2qiao22/STM32G473VET_main_controller_board/STM32G473VET_main_controller_board.kicad_pcb

## KiCad design STM32G473VET_main_controller_board.kicad_pcb (2026-08-07)

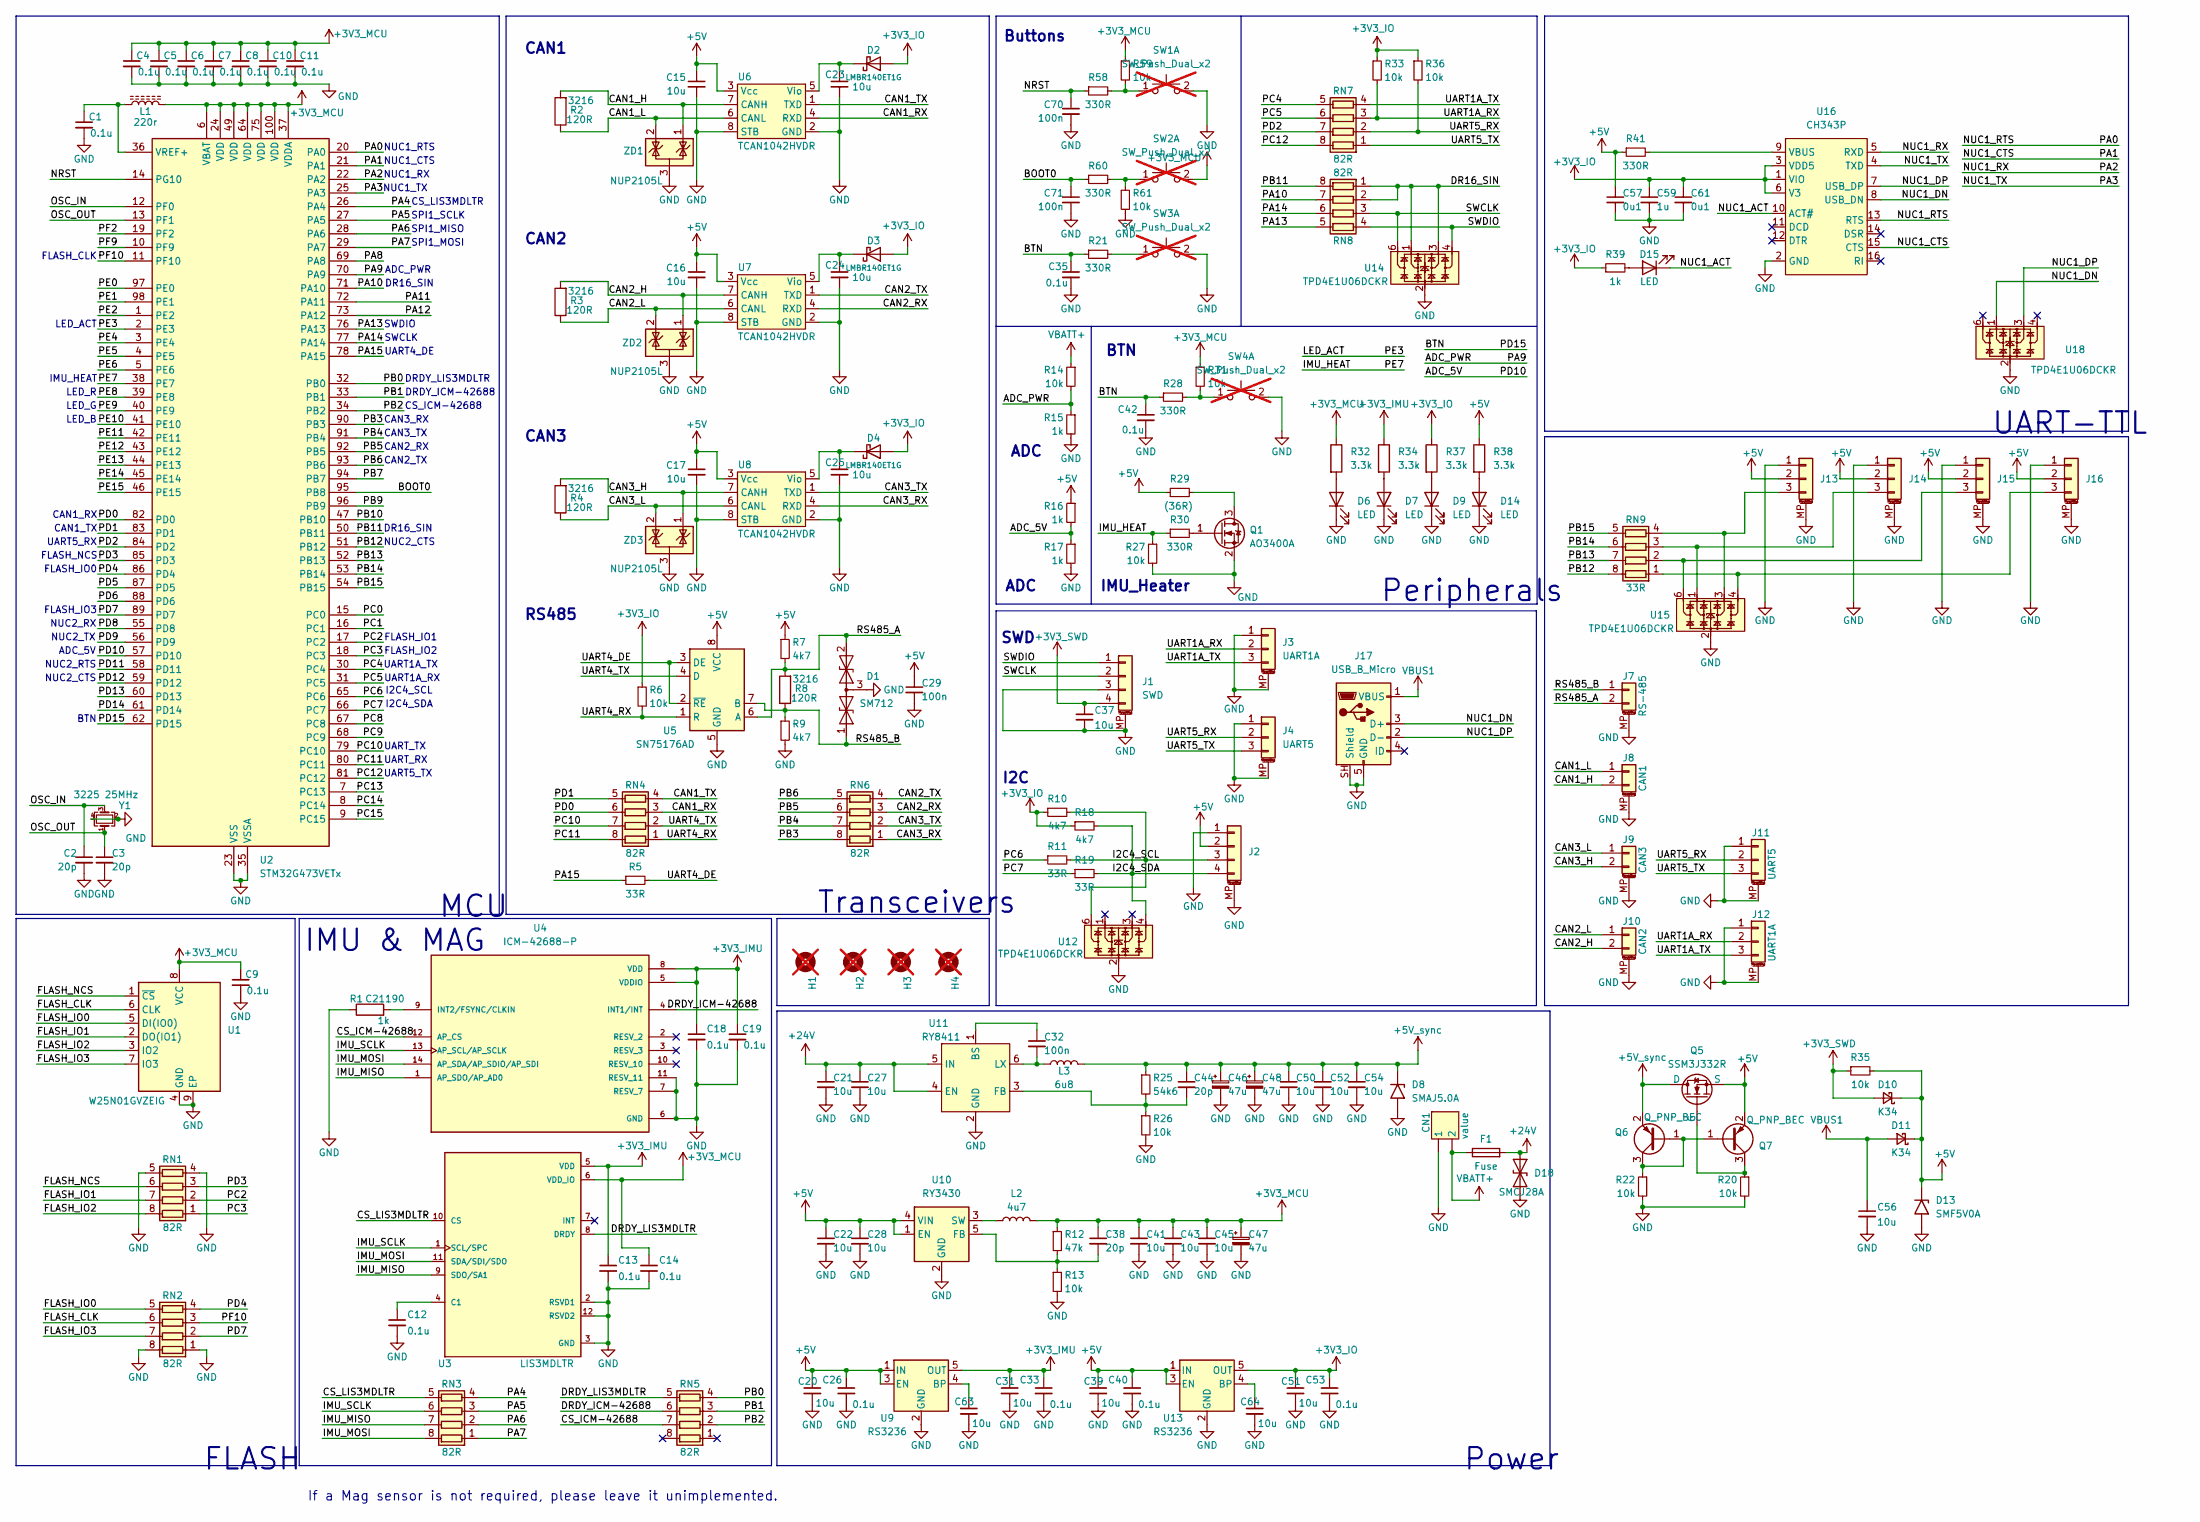
[picture p1: schematic STM32G473VET_main_controller_board.kicad_sch, STM32G473VET_General-purpose microcontroller board]

Parts:
C1, C4, C5, C6, C7, C8, C9, C10, C11, C12, C13, C14, C18, C19, C26, C33, C35, C40, C42, C53: 0.1u; C_0603_1608Metric; LCSC C14663
C2, C3, C38, C44: 20p; C_0603_1608Metric
C15, C16, C17, C20, C23, C24, C25, C31, C37, C39, C51, C56, C63, C64: 10u; C_1206_3216Metric; LCSC C13585
C21, C27, C50, C52, C54: 10u; C_1206_3216Metric
C22, C28, C41, C43, C45: 10u; C_0603_1608Metric
C29, C32, C70, C71: 100n; C_0603_1608Metric
C46, C47, C48: 47u; CP_EIA-3216-12_Kemet-S
C57, C61: 0u1; C_0603_1608Metric
C59: 1u; C_0603_1608Metric
CN1: value; AMASS_XT30PW-M_1x02_P2.50mm_Horizontal
D1: SM712; SOT-23
D2, D3, D4: LMBR140ET1G; D_TUMD2; LCSC C172430
D6, D7, D9, D14: LED; LED_0603_1608Metric; LCSC C510027
D8: SMAJ5.0A; D_SMA
D10, D11: K34; D_SMF
D13: SMF5V0A; D_SMF
D15: LED; LED_0603_1608Metric
D18: SMCJ28A; D_SMC
F1: Fuse; Fuse_1206_3216Metric
H1, H2, H3, H4: MountingHole; MountingHole_3.2mm_M3_ISO14580; not fitted
J1: SWD; Molex_PicoBlade_53398-0471_1x04-1MP_P1.25mm_Vertical
J2: Conn_01x04_MountingPin; 128x64OLED
J3: UART1A; JST_GH_BM03B-GHS-TBT_1x03-1MP_P1.25mm_Vertical
J4: UART5; JST_GH_BM03B-GHS-TBT_1x03-1MP_P1.25mm_Vertical
J7: RS-485; JST_GH_SM02B-GHS-TB_1x02-1MP_P1.25mm_Horizontal
J8: CAN1; JST_GH_SM02B-GHS-TB_1x02-1MP_P1.25mm_Horizontal
J9: CAN3; JST_GH_SM02B-GHS-TB_1x02-1MP_P1.25mm_Horizontal
J10: CAN2; JST_GH_SM02B-GHS-TB_1x02-1MP_P1.25mm_Horizontal
J11: UART5; JST_GH_SM03B-GHS-TB_1x03-1MP_P1.25mm_Horizontal
J12: UART1A; JST_GH_SM03B-GHS-TB_1x03-1MP_P1.25mm_Horizontal
J13, J14, J15, J16: Conn_01x03_MountingPin; JST_GH_BM03B-GHS-TBT_1x03-1MP_P1.25mm_Vertical
J17: USB_B_Micro; USB_Micro-B_Wuerth_629105150521
L1: 220r; L_0603_1608Metric
L2: 4u7; L_Sunlord_MWSA0402S
L3: 6u8; L_Sunlord_MWSA0402S
Q1: AO3400A; SOT-23
Q5: SSM3J332R; SOT-23-3
Q6, Q7: Q_PNP_BEC; SOT-23-3
R1: 1k; R_0603_1608Metric; LCSC C21190
R2, R3, R4, R8: 120R; R_1206_3216Metric; LCSC C17909
R5, R11, R19: 33R; R_0603_1608Metric
R6, R13, R14, R20, R22, R26, R27, R31, R33, R35, R36, R59, R61: 10k; R_0603_1608Metric
R7, R9, R10, R18: 4k7; R_0603_1608Metric
R12: 47k; R_0603_1608Metric
R15, R16, R17, R39: 1k; R_0603_1608Metric
R21, R28, R30, R41, R58, R60: 330R; R_0603_1608Metric
R25: 54k6; R_0603_1608Metric
R29: (36R); R_1206_3216Metric
R32, R34, R37, R38: 3.3k; R_0603_1608Metric; LCSC C4109
RN1, RN2, RN3, RN4, RN5, RN6, RN7, RN8: 82R; R_Array_Concave_4x0603
RN9: 33R; R_Array_Concave_4x0603
SW1, SW2, SW3, SW4: SW_Push_Dual_x2; SW_Push_TVAF06; not fitted
U1: W25N01GVZEIG; WSON-8-1EP_8x6mm_P1.27mm_EP3.4x4.3mm
U2: STM32G473VETx; LQFP-100_14x14mm_P0.5mm
U3: LIS3MDLTR; XDCR_LIS3MDLTR; PARTREV 6
U4: ICM-42688-P; PQFN50P300X250X97-14N; PARTREV 1.2; LCSC C48586483
U5: SN75176AD; SOIC-8_3.9x4.9mm_P1.27mm
U6, U7, U8: TCAN1042HVDR; SOIC-8_3.9x4.9mm_P1.27mm; LCSC C485807
U9, U13: RS3236; SOT-23-5
U10: RY3430; SOT-23-5
U11: RY8411; SOT-23-6
U12, U14, U15, U18: TPD4E1U06DCKR; SOT-363_SC-70-6
U16: CH343P; TQFN-16-1EP_3x3mm_P0.5mm_EP1.6x1.6mm
Y1: 3225 25MHz; Crystal_SMD_3225-4Pin_3.2x2.5mm
ZD1, ZD2, ZD3: NUP2105L; SOT-23; LCSC C14486

Connections:
+3V3_IMU: C13.1, C18.1, C19.1, C31.1, C33.1, R34.1, U3.5 (VDD), U4.5 (VDDIO), U4.8 (VDD), U9.5 (OUT)
+3V3_IO: C51.1, C53.1, C59.1, C61.1, D2.2 (A), D3.2 (A), D4.2 (A), R6.1, R10.1, R18.1, R33.1, R36.1, R37.1, R39.1, U13.5 (OUT), U16.1 (VIO), U16.3 (VDD5), U16.6 (V3)
+3V3_MCU: C4.1, C5.1, C6.1, C7.1, C8.1, C9.1, C10.1, C11.1, C14.1, C38.1, C41.1, C43.1, C45.1, C47.1, L1.2, L2.2, R12.1, R31.1, R32.1, R59.1, SW2.2 (D), U1.8 (VCC), U2.6 (VBAT), U2.24 (VDD), U2.37 (VDDA), U2.49 (VDD), U2.64 (VDD), U2.75 (VDD), U2.100 (VDD), U3.6 (VDD_IO); also elsewhere on the board
+3V3_SWD: C37.1, D10.2 (A), J1.4, R35.1
+5V: C15.1, C16.1, C17.1, C20.1, C22.1, C26.1, C28.1, C29.1, C39.1, C40.1, C57.1, D10.1 (K), D11.1 (K), D13.1 (A1), J2.2, J13.2, J14.2, J15.2, J16.2, Q5.3 (S), Q7.2 (E), R7.1, R16.1, R29.1, R35.2, R38.1, R41.1, U5.8 (VCC), U6.3 (Vcc), U7.3 (Vcc), U8.3 (Vcc), U9.1 (IN), U9.3 (EN), U10.1 (EN), U10.4 (VIN), U13.1 (IN), U13.3 (EN)
+5V_sync: C44.1, C46.1, C48.1, C50.1, C52.1, C54.1, D8.1 (A1), L3.2, Q5.1 (D), Q6.2 (E), R25.1
+24V: C21.1, C27.1, D18.1 (A1), F1.2, U11.4 (EN), U11.5 (IN)
/ADC_5V: R16.2, R17.1, U2.57 (PD10)
/ADC_PWR: R14.2, R15.1, U2.70 (PA9)
/BOOT0: C71.1, R60.1, U2.95 (PB8)
/BTN: C35.1, C42.1, R21.1, R28.1, U2.62 (PD15)
/CAN1_H: J8.2, R2.2, U6.7 (CANH), ZD1.1 (K)
/CAN1_L: J8.1, R2.1, U6.6 (CANL), ZD1.2 (K)
/CAN1_RX: RN4.3 (R3.1), U6.4 (RXD)
/CAN1_TX: RN4.4 (R4.1), U6.1 (TXD)
/CAN2_H: J10.2, R3.2, U7.7 (CANH), ZD2.1 (K)
/CAN2_L: J10.1, R3.1, U7.6 (CANL), ZD2.2 (K)
/CAN2_RX: RN6.3 (R3.1), U7.4 (RXD)
/CAN2_TX: RN6.4 (R4.1), U7.1 (TXD)
/CAN3_H: J9.2, R4.2, U8.7 (CANH), ZD3.1 (K)
/CAN3_L: J9.1, R4.1, U8.6 (CANL), ZD3.2 (K)
/CAN3_RX: RN6.1 (R1.1), U8.4 (RXD)
/CAN3_TX: RN6.2 (R2.1), U8.1 (TXD)
/CS_ICM-42688: RN5.7 (R2.2), U4.12 (AP_CS)
/CS_LIS3MDLTR: RN3.5 (R4.2), U3.10 (CS)
/DR16_SIN: RN8.1 (R1.1), RN8.2 (R2.1), U14.1, U14.3
/DRDY_ICM-42688: RN5.6 (R3.2), U4.4 (INT1/INT)
/DRDY_LIS3MDLTR: RN5.5 (R4.2), U3.8 (DRDY)
/FLASH_CLK: RN2.6 (R3.2), U1.6 (CLK)
/FLASH_IO0: RN2.5 (R4.2), U1.5 (DI(IO0))
/FLASH_IO1: RN1.7 (R2.2), U1.2 (DO(IO1))
/FLASH_IO2: RN1.8 (R1.2), U1.3 (IO2)
/FLASH_IO3: RN2.7 (R2.2), U1.7 (IO3)
/FLASH_NCS: RN1.6 (R3.2), U1.1 (~CS)
/I2C4_SCL: J2.3, R10.2, R11.2, U12.6
/I2C4_SDA: J2.4, R18.2, R19.2, U12.4
/IMU_HEAT: R27.1, R30.1, U2.38 (PE7)
/IMU_MISO: RN3.7 (R2.2), U3.9 (SDO/SA1), U4.1 (AP_SDO/AP_AD0)
/IMU_MOSI: RN3.8 (R1.2), U3.11 (SDA/SDI/SDO), U4.14 (AP_SDA/AP_SDIO/AP_SDI)
/IMU_SCLK: RN3.6 (R3.2), U3.1 (SCL/SPC), U4.13 (AP_SCL/AP_SCLK)
/LED_ACT: U2.2 (PE3)
/NRST: C70.1, R58.1, U2.14 (PG10)
/NUC1_ACT: D15.1 (K), U16.10 (ACT#)
/NUC1_CTS: U2.21 (PA1), U16.15 (CTS)
/NUC1_DN: J17.3 (D+), U16.8 (USB_DN), U18.1
/NUC1_DP: J17.2 (D-), U16.7 (USB_DP), U18.3
/NUC1_RTS: U2.20 (PA0), U16.13 (RTS)
/NUC1_RX: U2.22 (PA2), U16.5 (RXD)
/NUC1_TX: U2.25 (PA3), U16.4 (TXD)
/OSC_IN: C2.1, U2.12 (PF0), Y1.3
/OSC_OUT: C3.1, U2.13 (PF1), Y1.1
/PA4: RN3.4 (R4.1), U2.26 (PA4)
/PA5: RN3.3 (R3.1), U2.27 (PA5)
/PA6: RN3.2 (R2.1), U2.28 (PA6)
/PA7: RN3.1 (R1.1), U2.29 (PA7)
/PA8: U2.69 (PA8)
/PA10: RN8.7 (R2.2), U2.71 (PA10)
/PA11: U2.72 (PA11)
/PA12: U2.73 (PA12)
/PA13: RN8.5 (R4.2), U2.76 (PA13)
/PA14: RN8.6 (R3.2), U2.77 (PA14)
/PA15: R5.1, U2.78 (PA15)
/PB0: RN5.4 (R4.1), U2.32 (PB0)
/PB1: RN5.3 (R3.1), U2.33 (PB1)
/PB2: RN5.2 (R2.1), U2.34 (PB2)
/PB3: RN6.8 (R1.2), U2.90 (PB3)
/PB4: RN6.7 (R2.2), U2.91 (PB4)
/PB5: RN6.6 (R3.2), U2.92 (PB5)
/PB6: RN6.5 (R4.2), U2.93 (PB6)
/PB7: U2.94 (PB7)
/PB9: U2.96 (PB9)
/PB10: U2.47 (PB10)
/PB11: RN8.8 (R1.2), U2.50 (PB11)
/PB12: RN9.8 (R1.2), U2.51 (PB12)
/PB13: RN9.7 (R2.2), U2.52 (PB13)
/PB14: RN9.6 (R3.2), U2.53 (PB14)
/PB15: RN9.5 (R4.2), U2.54 (PB15)
/PC0: U2.15 (PC0)
/PC1: U2.16 (PC1)
/PC2: RN1.2 (R2.1), U2.17 (PC2)
/PC3: RN1.1 (R1.1), U2.18 (PC3)
/PC4: RN7.5 (R4.2), U2.30 (PC4)
/PC5: RN7.6 (R3.2), U2.31 (PC5)
/PC6: R11.1, U2.65 (PC6)
/PC7: R19.1, U2.66 (PC7)
/PC8: U2.67 (PC8)
/PC9: U2.68 (PC9)
/PC10: RN4.7 (R2.2), U2.79 (PC10)
/PC11: RN4.8 (R1.2), U2.80 (PC11)
/PC12: RN7.8 (R1.2), U2.81 (PC12)
/PC13: U2.7 (PC13)
/PC14: U2.8 (PC14)
/PC15: U2.9 (PC15)
/PD0: RN4.6 (R3.2), U2.82 (PD0)
/PD1: RN4.5 (R4.2), U2.83 (PD1)
/PD2: RN7.7 (R2.2), U2.84 (PD2)
/PD3: RN1.3 (R3.1), U2.85 (PD3)
/PD4: RN2.4 (R4.1), U2.86 (PD4)
/PD5: U2.87 (PD5)
/PD6: U2.88 (PD6)
/PD7: RN2.2 (R2.1), U2.89 (PD7)
/PD8: U2.55 (PD8)
/PD9: U2.56 (PD9)
/PD11: U2.58 (PD11)
/PD12: U2.59 (PD12)
/PD13: U2.60 (PD13)
/PD14: U2.61 (PD14)
/PE0: U2.97 (PE0)
/PE1: U2.98 (PE1)
/PE2: U2.1 (PE2)
/PE4: U2.3 (PE4)
/PE5: U2.4 (PE5)
/PE6: U2.5 (PE6)
/PE8: U2.39 (PE8)
/PE9: U2.40 (PE9)
/PE10: U2.41 (PE10)
/PE11: U2.42 (PE11)
/PE12: U2.43 (PE12)
/PE13: U2.44 (PE13)
/PE14: U2.45 (PE14)
/PE15: U2.46 (PE15)
/PF2: U2.19 (PF2)
/PF9: U2.10 (PF9)
/PF10: RN2.3 (R3.1), U2.11 (PF10)
/RS485_A: D1.2 (A2), J7.2, R7.2, R8.2, U5.6 (A)
/RS485_B: D1.1 (A1), J7.1, R8.1, R9.1, U5.7 (B)
/SWCLK: J1.2, RN8.3 (R3.1), U14.6
/SWDIO: J1.1, RN8.4 (R4.1), U14.4
/UART1A_RX: J3.2, J12.2, R33.2, RN7.3 (R3.1)
/UART1A_TX: J3.3, J12.3, RN7.4 (R4.1)
/UART4_DE: R5.2, U5.2 (~RE), U5.3 (DE)
/UART4_RX: R6.2, RN4.1 (R1.1), U5.1 (R)
/UART4_TX: RN4.2 (R2.1), U5.4 (D)
/UART5_RX: J4.2, J11.2, R36.2, RN7.2 (R2.1)
/UART5_TX: J4.3, J11.3, RN7.1 (R1.1)
GND: C1.2, C2.2, C3.2, C4.2, C5.2, C6.2, C7.2, C8.2, C9.2, C10.2, C11.2, C12.2, C13.2, C14.2, C15.2, C16.2, C17.2, C18.2, C19.2, C20.2, C21.2, C22.2, C23.2, C24.2, C25.2, C26.2, C27.2, C28.2, C29.2, C31.2, C33.2, C35.2, C37.2, C39.2, C40.2, C41.2, C42.2, C43.2, C45.2, C46.2, C47.2, C48.2, C50.2, C51.2, C52.2, C53.2, C54.2, C56.2, C57.2, C59.2, C61.2, C63.2, C64.2, C70.2, C71.2, CN1.1, D1.3 (common), D6.1 (K), D7.1 (K), D8.2 (A2), D9.1 (K), D13.2 (A2), D14.1 (K), D18.2 (A2), J1.3, J1.MP (MountPin), J2.1, J2.MP (MountPin), J3.1, J3.MP (MountPin), J4.1, J4.MP (MountPin), J7.MP (MountPin), J8.MP (MountPin), J9.MP (MountPin), J10.MP (MountPin), J11.1, J11.MP (MountPin), J12.1, J12.MP (MountPin), J13.1, J13.MP (MountPin), J14.1, J14.MP (MountPin), J15.1, J15.MP (MountPin), J16.1, J16.MP (MountPin), J17.5 (GND), J17.SH (Shield), Q1.2 (S), R1.1, R9.2, R13.2, R15.2, R17.2, R20.2, R22.2, R26.2, R27.2, R61.2, RN1.4 (R4.1), RN1.5 (R4.2), RN2.1 (R1.1), RN2.8 (R1.2), SW1.2 (D), SW3.2 (D), SW4.2 (D), U1.4 (GND), U1.9 (EP), U2.23 (VSS), U2.35 (VSSA), U2.48 (VSS), U2.63 (VSS), U2.74 (VSS), U2.99 (VSS), U3.2 (RSVD1), U3.3 (GND), U3.12 (RSVD2), U4.6 (GND), U4.7 (RESV_7), U4.11 (RESV_11), U5.5 (GND), U6.2 (GND), U6.8 (STB), U7.2 (GND), U7.8 (STB), U8.2 (GND), U8.8 (STB), U9.2 (GND), U10.2 (GND), U11.2 (GND), U12.2, U13.2 (GND), U14.2, U15.2, U16.2 (GND), U16.17 (GND), U18.2, Y1.2, Y1.4, ZD1.3 (A), ZD2.3 (A), ZD3.3 (A)
unnamed: C23.1, D2.1 (K), U6.5 (Vio)
unnamed: C24.1, D3.1 (K), U7.5 (Vio)
unnamed: C25.1, D4.1 (K), U8.5 (Vio)
unnamed: D6.2 (A), R32.2
unnamed: D7.2 (A), R34.2
unnamed: D9.2 (A), R37.2
unnamed: D14.2 (A), R38.2
unnamed: D15.2 (A), R39.2
unnamed: J13.3, RN9.4 (R4.1), U15.3
unnamed: J14.3, RN9.3 (R3.1), U15.1
unnamed: J15.3, RN9.2 (R2.1), U15.6
unnamed: J16.3, RN9.1 (R1.1), U15.4
unnamed: Q1.3 (D), R29.2
unnamed: Q1.1 (G), R30.2
unnamed: Q5.2 (G), Q7.3 (C), R20.1
unnamed: Q6.1 (B), Q6.3 (C), Q7.1 (B), R22.1
unnamed: R58.2, R59.2, SW1.1 (C)
unnamed: R60.2, R61.1, SW2.1 (C)
unnamed: R21.2, SW3.1 (C)
unnamed: R28.2, R31.2, SW4.1 (C)
unnamed: C1.1, L1.1, U2.36 (VREF+)
unnamed: C12.1, U3.4 (C1)
unnamed: R1.2, U4.9 (INT2/FSYNC/CLKIN)
unnamed: C63.1, U9.4 (BP)
unnamed: C38.2, R12.2, R13.1, U10.5 (FB)
unnamed: L2.1, U10.3 (SW)
unnamed: C32.1, U11.1 (BS)
unnamed: C44.2, R25.2, R26.1, U11.3 (FB)
unnamed: C32.2, L3.1, U11.6 (LX)
unnamed: C64.1, U13.4 (BP)
unnamed: R41.2, U16.9 (VBUS)
VBATT+: CN1.2, F1.1, R14.1
VBUS1: C56.1, D11.2 (A), J17.1 (VBUS)

Notes on the sheet:
CS_LIS3MDLTR
LED_ACT
ADC_5V
SWCLK
NUC2_TX
NUC2_CTS
SWD
LED_B
CAN2_RX
NUC1_CTS
BTN
I2C4_SDA
FLASH
FLASH_IO3
UART_TX
SPI1_MOSI
UART5_RX
MCU
NUC1_RTS
CAN3_TX
IMU & MAG
ADC
Buttons
CAN3
UART-TTL
NUC2_RX
UART5_TX
UART_RX
CAN1_TX
UART1A_RX
NUC2_RTS
FLASH_NCS
FLASH_IO0
If a Mag sensor is not required, please leave it unimplemented.
Peripherals
UART4_DE
Transceivers
ADC_PWR
UART1A_TX
CAN3_RX
CS_ICM-42688
NUC1_RX
I2C
FLASH_IO1
LED_G
SPI1_MISO
I2C4_SCL
DR16_SIN
SPI1_SCLK
Power
RS485
IMU_Heater
CAN1
IMU_HEAT
FLASH_CLK
SWDIO
DRDY_ICM-42688
NUC1_TX
CAN2_TX
FLASH_IO2
CAN2
CAN1_RX
LED_R
DRDY_LIS3MDLTR

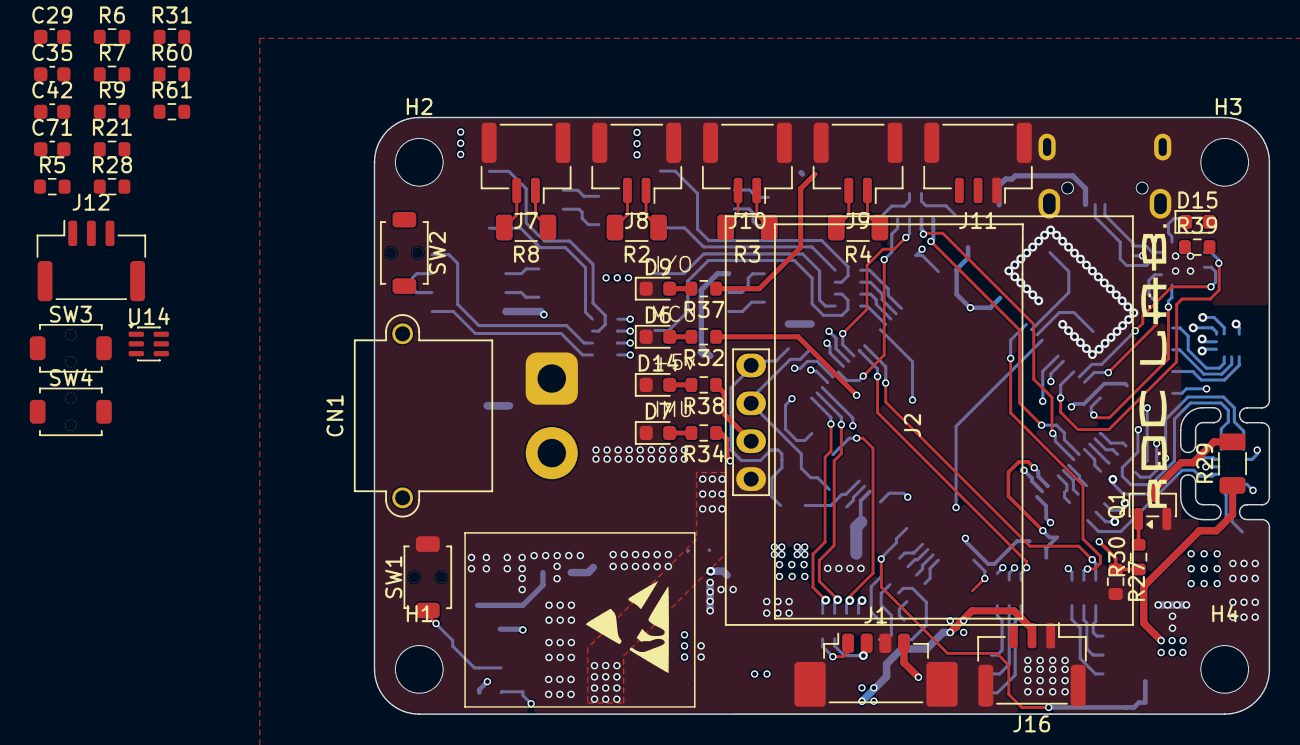
[picture p2: board STM32G473VET_main_controller_board.kicad_pcb from above]

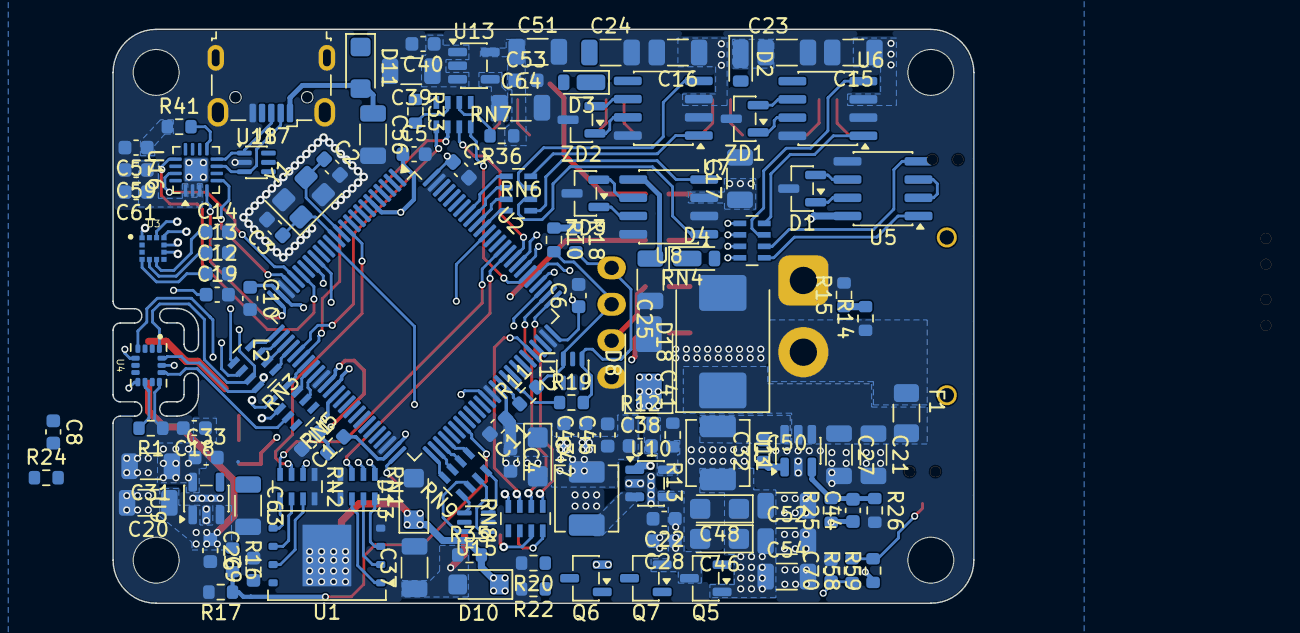
[picture p3: board STM32G473VET_main_controller_board.kicad_pcb from below]

Board: 4 copper layers, 60.0 x 40.0 mm, 172 parts (122 on the bottom side), 131 nets.

Other parts of the board:
R24: 10k; R_0603_1608Metric

Their connections:
+3V3_MCU: R24.1; also elsewhere on the board
